Thunkar/ArmDuinoV2/README.md

# ArmDuinoV2
Second version of the robotic arm. Now including hardware, software and (some) documentation.
