Thunkar/ArmDuinoV2/Piezas STL/README.txt

1 Base ventosa
1 BrazoPinza
1 BrazoPinza2
2 Enlace1
2 Enlace2Base
1 Enlace2
1 Pinza
3 SoporteVentosa

5 Servos pequeños http://www.hobbyking.com/hobbyking/store/__32095__Turnigy_TG9_9g_1_7kg_0_12sec_Eco_Micro_Servo.html
2 Servos grandes http://www.hobbyking.com/hobbyking/store/__39340__HXT_6_9kg_39_2g_16sec_Twin_bearing_servo_EU_warehouse_.html
1 Fuente de alimentación 5V 4A (el cacharro consume hasta 2.5-2.7A)
1 Placa Arduino
