Thunkar/ArmDuinoV2/Documentación/KinectMappingVertical.jpg

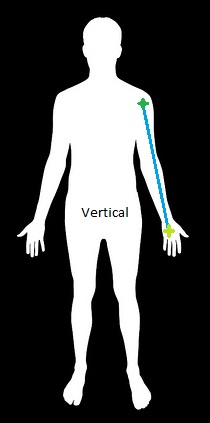
Documentación/KinectMappingVertical.jpg
