Thunkar/ArmDuinoV2/Piezas STL/BrazoCompleto.stl

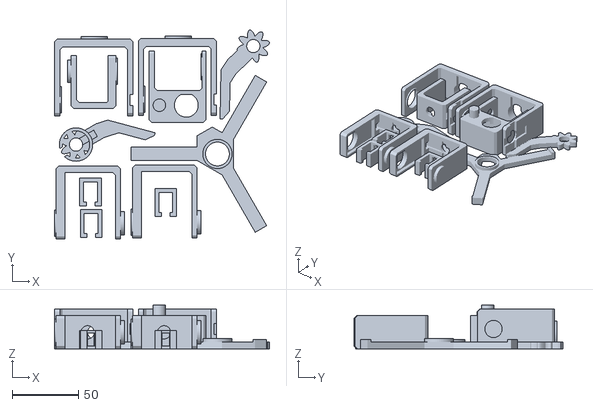
[picture p11: CAD file, 2015-02-28]
Piezas STL/BrazoCompleto.stl
162.3 x 157.9 x 33.0
