Thunkar/ArmDuinoV2/Piezas STL/BrazoPinza2.stl

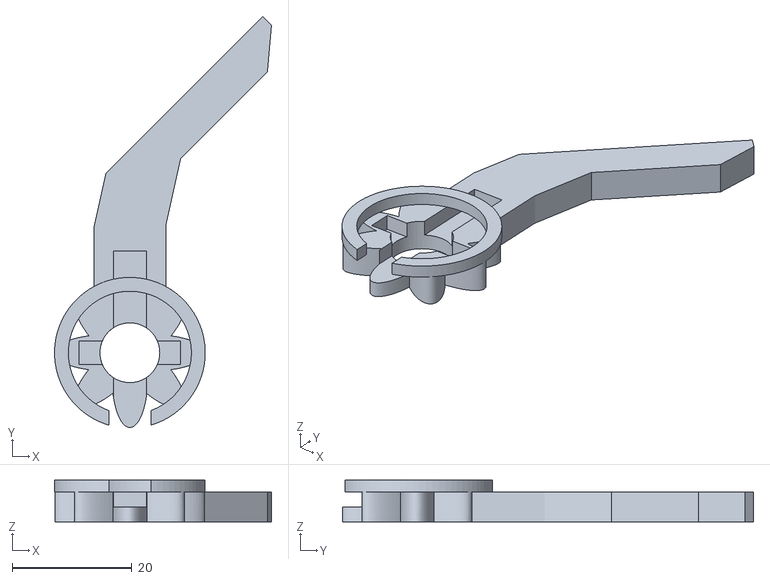
[picture p12: CAD file, 2015-02-28]
Piezas STL/BrazoPinza2.stl
36.3 x 68.7 x 7.00
