Thunkar/ArmDuinoV2/Piezas STL/Enlace1.stl

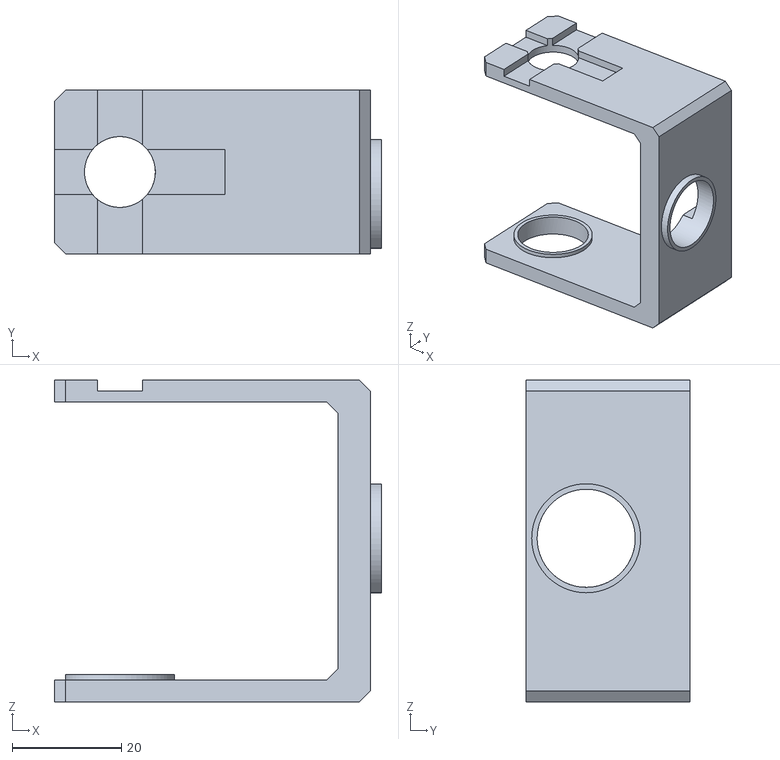
[picture p13: CAD file, 2015-02-28]
Piezas STL/Enlace1.stl
60.0 x 30.0 x 59.0
