Thunkar/ArmDuinoV2/Piezas STL/Pinza.stl

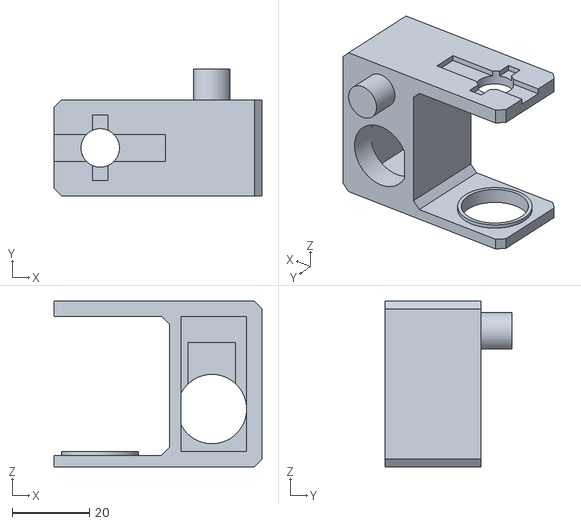
[picture p14: CAD file, 2015-02-28]
Piezas STL/Pinza.stl
54.0 x 33.0 x 43.0
