Thunkar/ArmDuinoV2/Piezas STL/BaseVentosa.stl

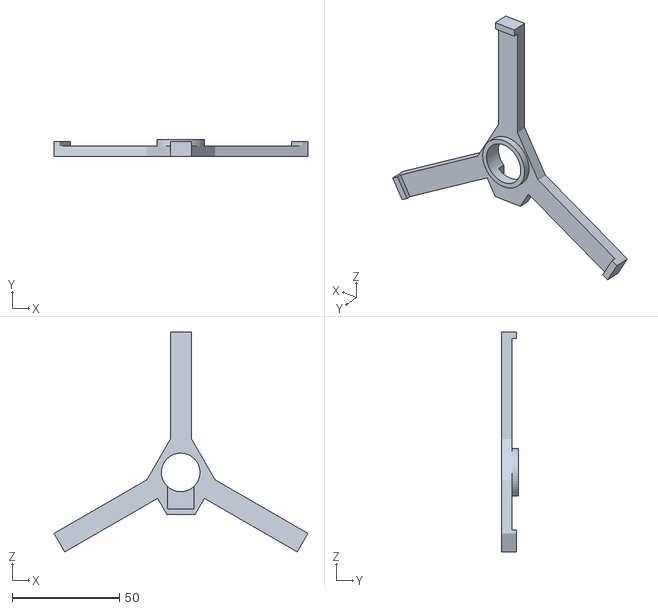
[picture p15: CAD file, 2015-02-28]
Piezas STL/BaseVentosa.stl
118.4 x 8.00 x 102.6
