Thunkar/ArmDuinoV2/Piezas STL/BrazoPinza.stl

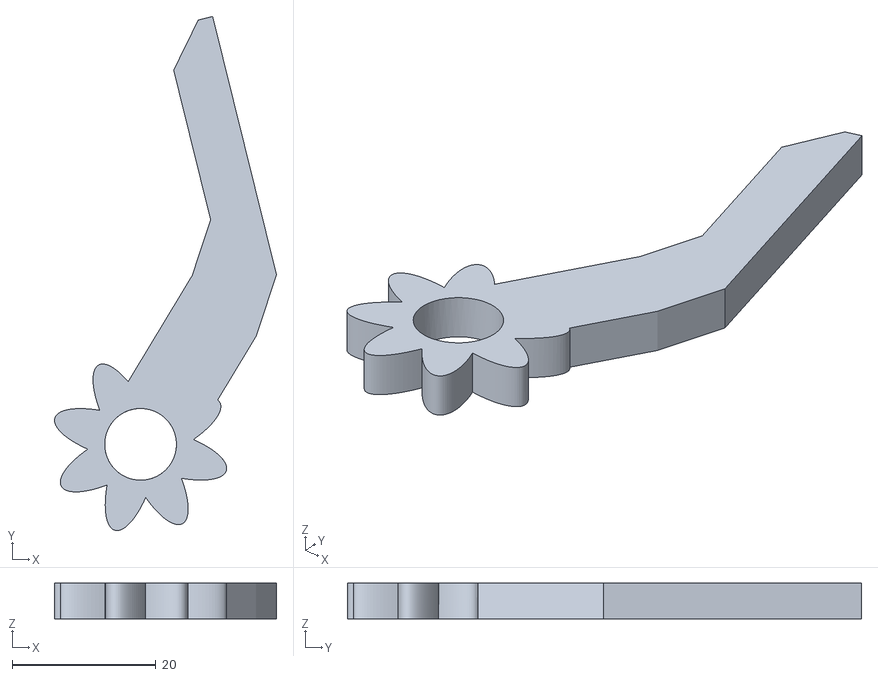
[picture p16: CAD file, 2015-02-28]
Piezas STL/BrazoPinza.stl
30.9 x 71.6 x 5.00
