Thunkar/ArmDuinoV2/Piezas STL/Enlace2Base.stl

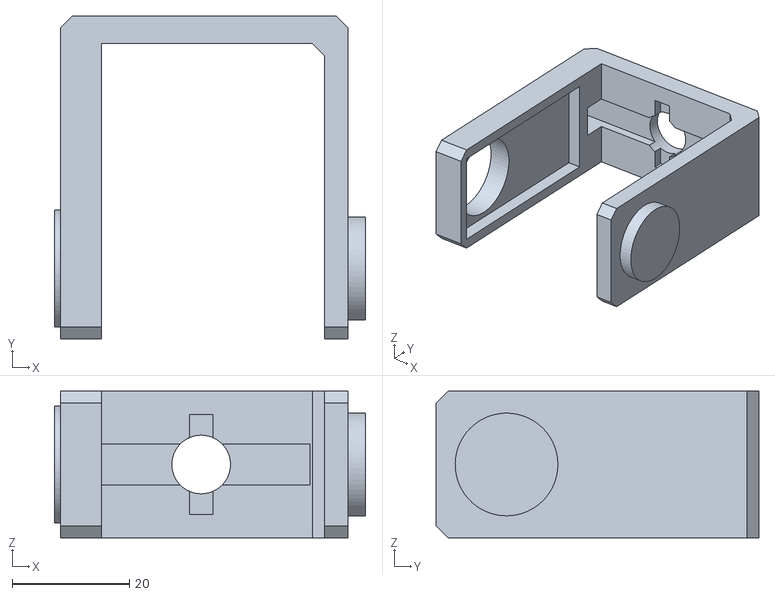
[picture p17: CAD file, 2015-02-28]
Piezas STL/Enlace2Base.stl
53.0 x 55.0 x 25.0
