Thunkar/ArmDuinoV2/Piezas STL/SoporteVentosa.stl

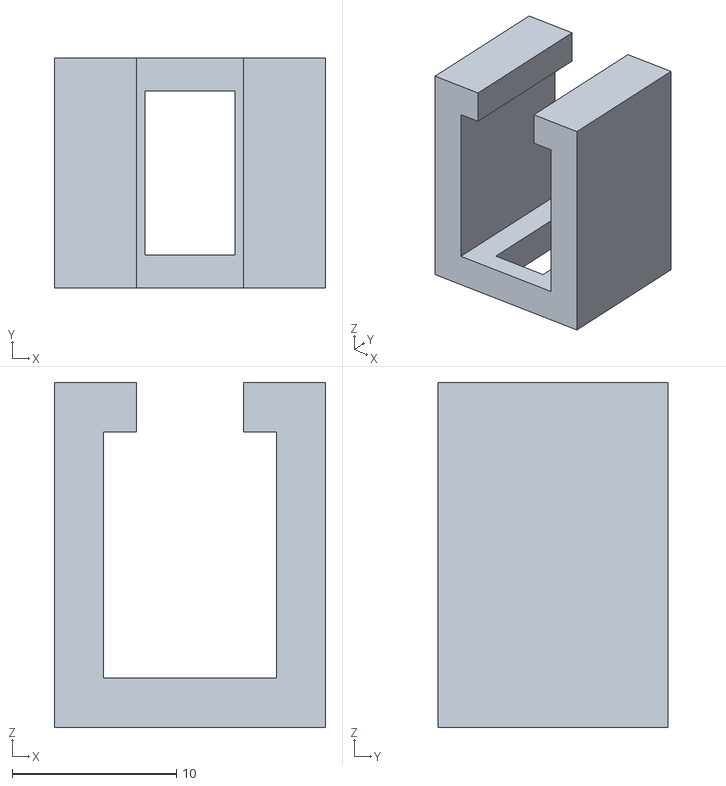
[picture p18: CAD file, 2015-02-28]
Piezas STL/SoporteVentosa.stl
16.5 x 14.0 x 21.0
