Thunkar/ArmDuinoV2/Piezas STL/Enlace2.stl

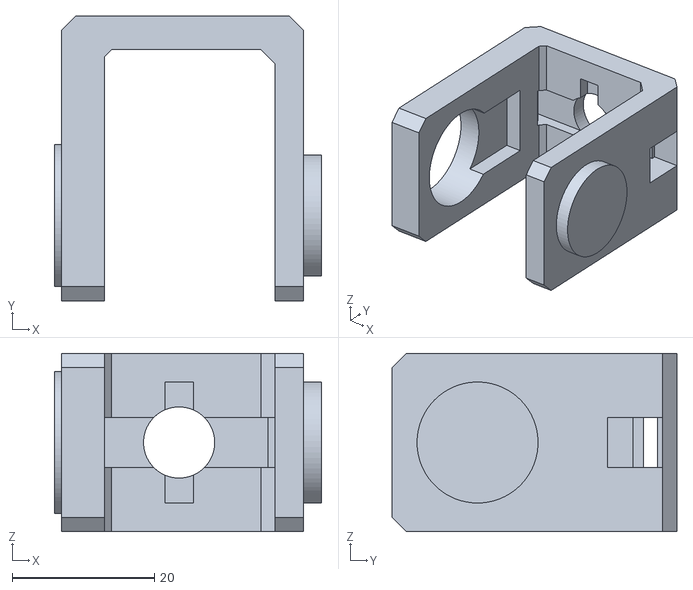
[picture p19: CAD file, 2015-02-28]
Piezas STL/Enlace2.stl
37.5 x 40.0 x 25.0
