Thunkar/ArmDuinoV2/(list of files, cad)

Other CAD files:
Piezas Inventor/Base.ipt
Piezas Inventor/BaseVentosa.ipt
Piezas Inventor/Brazo.iam
Piezas Inventor/BrazoPinza.ipt
Piezas Inventor/BrazoPinza2.ipt
Piezas Inventor/Enlace1.ipt
Piezas Inventor/Enlace2.ipt
Piezas Inventor/Enlace2Base.ipt
Piezas Inventor/OldVersions/BaseVentosa.0004.ipt
Piezas Inventor/OldVersions/Brazo.0084.iam
Piezas Inventor/OldVersions/BrazoPinza.0018.ipt
Piezas Inventor/OldVersions/BrazoPinza2.0017.ipt
Piezas Inventor/OldVersions/Enlace1.0044.ipt
Piezas Inventor/OldVersions/Enlace2.0041.ipt
Piezas Inventor/OldVersions/Enlace2Base.0014.ipt
Piezas Inventor/OldVersions/Servo.0003.ipt
Piezas Inventor/OldVersions/Servo2.0001.ipt
Piezas Inventor/OldVersions/SoporteVentosa.0003.ipt
Piezas Inventor/Pata.ipt
Piezas Inventor/Pinza.ipt
Piezas Inventor/Plano.ipt
Piezas Inventor/Servo.ipt
Piezas Inventor/Servo2.ipt
Piezas Inventor/SoporteVentosa.ipt
