Thunkar/ArmDuinoV2/Electrónica/Motores+Bluetooth/Motores+Bluetoothv4.brd

## EAGLE design Electrónica/Motores+Bluetooth/Motores+Bluetoothv4.brd (2015-02-28)

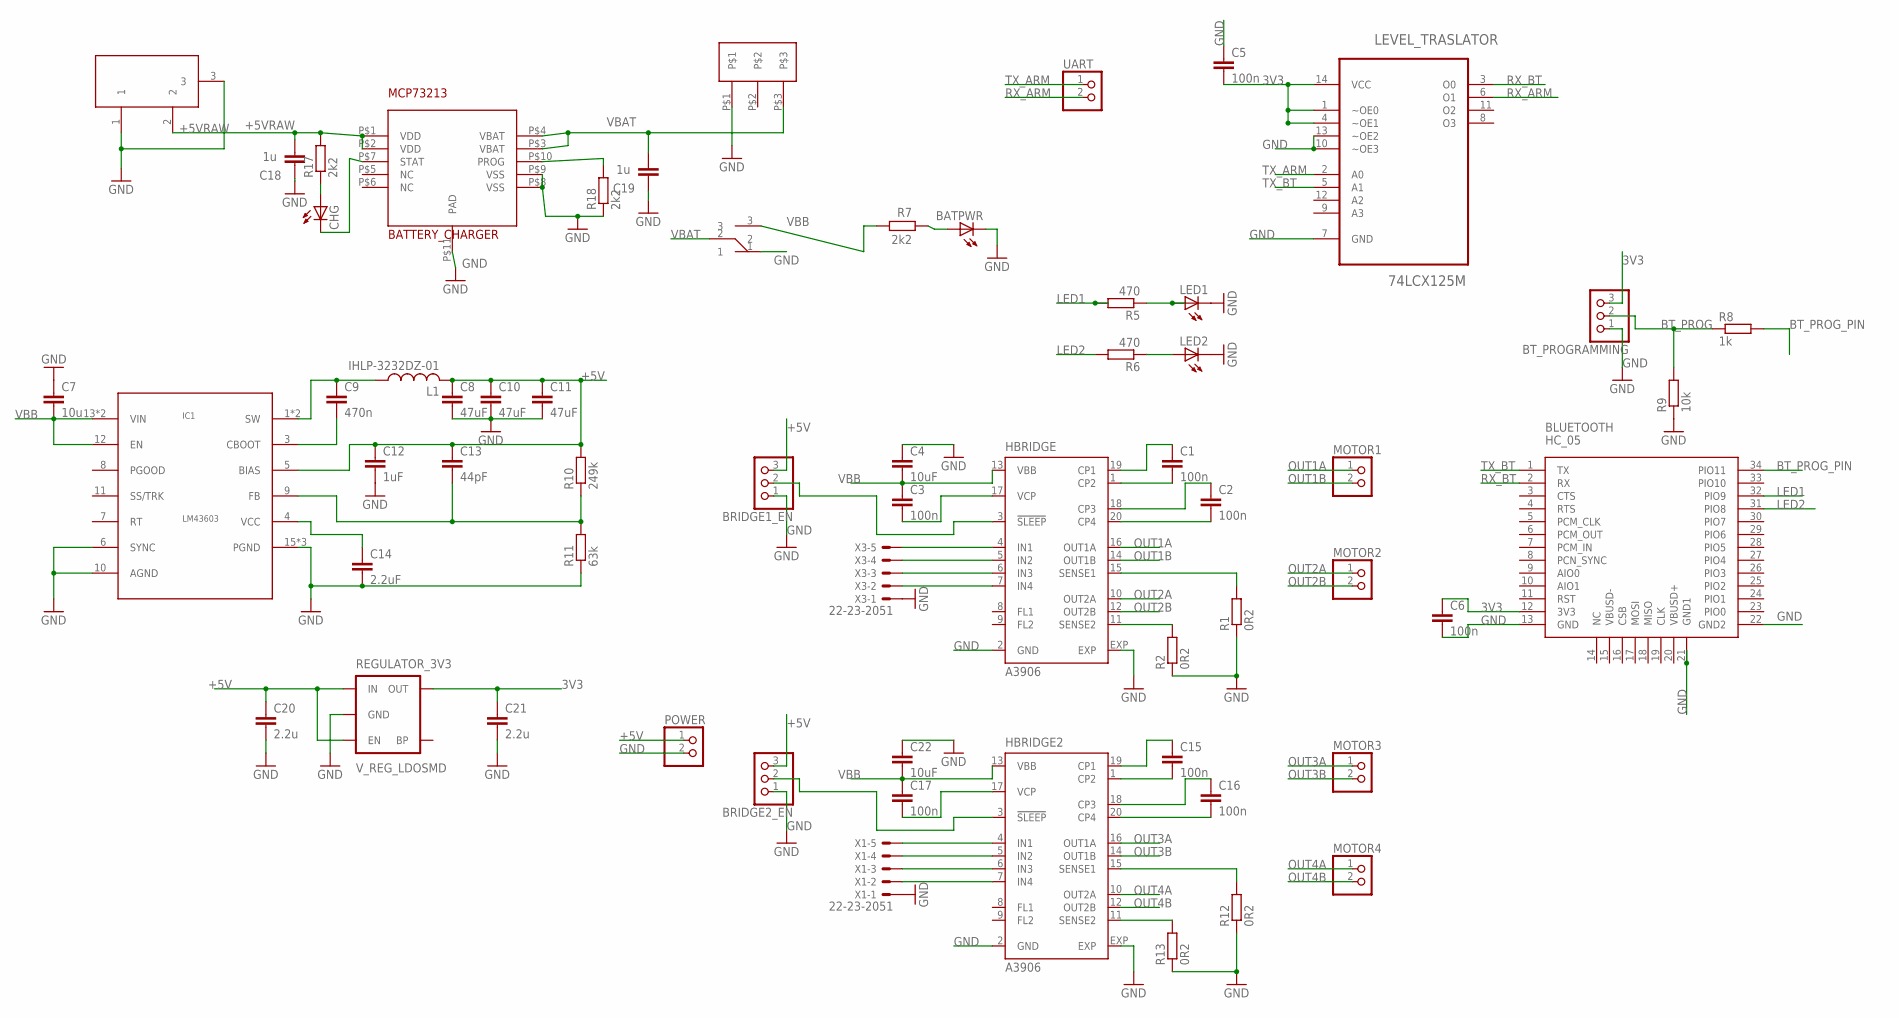
[picture p20: schematic Motores+Bluetoothv4.sch]

Parts:
BATPWR: LEDCHIPLED_0603; CHIPLED_0603
BATTERY_CHARGER: MCP73213; DFN103X3
BLUETOOTH: HC_05; BLUETOOTH_SMD
BRIDGE1_EN, BRIDGE2_EN: PINHD-1X3ROUND; 1X03ROUND
BT_PROGRAMMING: PINHD-1X3ROUND; 1X03ROUND
C1, C2, C3, C5, C6, C15, C16, C17: 100n; C0603
C4, C22: 10uF; C0805
C7: 10u; C1206
C8, C10, C11: 47uF; C1210
C9: 470n; C0603
C12: 1uF; C0805
C13: 44pF; C0603
C14: 2.2uF; C0805
C18, C19: 1u; C0603
C20, C21: 2.2u; C0603K
CHG: LEDCHIPLED_0603; CHIPLED_0603
HBRIDGE, HBRIDGE2: A3906; QFN20
IC1: LM43603; PW_R-PDSO-G16
L1: IHLP-3232DZ-01
LED1, LED2: LEDCHIP-LED0603; CHIP-LED0603
LEVEL_TRASLATOR: 74LCX125M; SOIC127P600X175-14N
MOTOR1, MOTOR2, MOTOR3, MOTOR4: PINHD-1X2ROUND; 1X02ROUND
POWER: PINHD-1X2ROUND; 1X02ROUND
R1, R2, R12, R13: 0R2; R0805
R5, R6: 470; R0603
R7, R17, R18: 2k2; R0603
R8: 1k; R0603
R9: 10k; R0603
R10: 249k; R0603
R11: 63k; R0603
REGULATOR_3V3: V_REG_LDOSMD; SOT23-5
U$1: 100SP1T1B4M2QE
U$3: JST-XHA-3
UART: PINHD-1X2ROUND; 1X02ROUND
X1, X3: 22-23-2051
X2: DC21MMX; DC-21MM

Connections:
3V3: BLUETOOTH.12 (3V3), BT_PROGRAMMING.3, C5.2, C6.1, C21.1, LEVEL_TRASLATOR.1 (~OE0), LEVEL_TRASLATOR.4 (~OE1), LEVEL_TRASLATOR.14 (VCC), REGULATOR_3V3.5 (OUT)
+5V: BRIDGE1_EN.3, BRIDGE2_EN.3, C8.1, C10.1, C11.1, C12.1, C13.1, C20.1, IC1.5 (BIAS), L1.P$2 (2), POWER.1, R10.2, REGULATOR_3V3.1 (IN), REGULATOR_3V3.3 (EN)
+5VRAW: BATTERY_CHARGER.P$1 (VDD), BATTERY_CHARGER.P$2 (VDD), C18.1, R17.2, X2.2
BT_PROG: BT_PROGRAMMING.2, R8.1, R9.2
BT_PROG_PIN: BLUETOOTH.34 (PIO11), R8.2
GND: BATPWR.C, BATTERY_CHARGER.P$8 (VSS), BATTERY_CHARGER.P$9 (VSS), BATTERY_CHARGER.P$11 (PAD), BLUETOOTH.13 (GND), BLUETOOTH.21 (GND1), BLUETOOTH.22 (GND2), BRIDGE1_EN.1, BRIDGE2_EN.1, BT_PROGRAMMING.1, C4.1, C5.1, C6.2, C7.1, C8.2, C10.2, C11.2, C12.2, C14.2, C18.2, C19.2, C20.2, C21.2, C22.1, HBRIDGE.2 (GND), HBRIDGE.EXP, HBRIDGE2.2 (GND), HBRIDGE2.EXP, IC1.6 (SYNC), IC1.10 (AGND), IC1.15 (PGND), IC1.16 (PGND), IC1.TP (PGND), LED1.C, LED2.C, LEVEL_TRASLATOR.7 (GND), LEVEL_TRASLATOR.10 (~OE3), LEVEL_TRASLATOR.13 (~OE2), POWER.2, R1.1, R2.1, R9.1, R11.1, R12.1, R13.1, R18.1, REGULATOR_3V3.2 (GND), U$1.1, U$3.P$1, X1.1, X2.1, X2.3, X3.1
LED1: BLUETOOTH.32 (PIO9), R5.2
LED2: BLUETOOTH.31 (PIO8), R6.2
unnamed: C1.1, HBRIDGE.19 (CP1)
unnamed: C1.2, HBRIDGE.1 (CP2)
unnamed: C2.1, HBRIDGE.18 (CP3)
unnamed: C2.2, HBRIDGE.20 (CP4)
unnamed: C3.2, HBRIDGE.17 (VCP)
unnamed: LED2.A, R6.1
unnamed: HBRIDGE.15 (SENSE1), R1.2
unnamed: HBRIDGE.11 (SENSE2), R2.2
unnamed: HBRIDGE.4 (IN1), X3.5
unnamed: HBRIDGE.5 (IN2), X3.4
unnamed: HBRIDGE.6 (IN3), X3.3
unnamed: HBRIDGE.7 (IN4), X3.2
unnamed: BRIDGE1_EN.2, HBRIDGE.3 (!SLEEP)
unnamed: LED1.A, R5.1
unnamed: BATPWR.A, R7.2
unnamed: C9.2, IC1.3 (CBOOT)
unnamed: C9.1, IC1.1 (SW), IC1.2 (SW), L1.P$1 (1)
unnamed: C14.1, IC1.4 (VCC)
unnamed: C13.2, IC1.9 (FB), R10.1, R11.2
unnamed: C15.1, HBRIDGE2.19 (CP1)
unnamed: C15.2, HBRIDGE2.1 (CP2)
unnamed: C16.1, HBRIDGE2.18 (CP3)
unnamed: C16.2, HBRIDGE2.20 (CP4)
unnamed: C17.2, HBRIDGE2.17 (VCP)
unnamed: HBRIDGE2.15 (SENSE1), R12.2
unnamed: HBRIDGE2.11 (SENSE2), R13.2
unnamed: HBRIDGE2.4 (IN1), X1.5
unnamed: HBRIDGE2.5 (IN2), X1.4
unnamed: HBRIDGE2.6 (IN3), X1.3
unnamed: HBRIDGE2.7 (IN4), X1.2
unnamed: BRIDGE2_EN.2, HBRIDGE2.3 (!SLEEP)
unnamed: CHG.A, R17.1
unnamed: BATTERY_CHARGER.P$7 (STAT), CHG.C
unnamed: BATTERY_CHARGER.P$10 (PROG), R18.2
OUT1A: HBRIDGE.16 (OUT1A), MOTOR1.1
OUT1B: HBRIDGE.14 (OUT1B), MOTOR1.2
OUT2A: HBRIDGE.10 (OUT2A), MOTOR2.1
OUT2B: HBRIDGE.12 (OUT2B), MOTOR2.2
OUT3A: HBRIDGE2.16 (OUT1A), MOTOR3.1
OUT3B: HBRIDGE2.14 (OUT1B), MOTOR3.2
OUT4A: HBRIDGE2.10 (OUT2A), MOTOR4.1
OUT4B: HBRIDGE2.12 (OUT2B), MOTOR4.2
RX_ARM: LEVEL_TRASLATOR.6 (O1), UART.2
RX_BT: BLUETOOTH.2 (RX), LEVEL_TRASLATOR.3 (O0)
TX_ARM: LEVEL_TRASLATOR.2 (A0), UART.1
TX_BT: BLUETOOTH.1 (TX), LEVEL_TRASLATOR.5 (A1)
VBAT: BATTERY_CHARGER.P$3 (VBAT), BATTERY_CHARGER.P$4 (VBAT), C19.1, U$1.2, U$3.P$3
VBB: C3.1, C4.2, C7.2, C17.1, C22.2, HBRIDGE.13 (VBB), HBRIDGE2.13 (VBB), IC1.12 (EN), IC1.13 (VIN), IC1.14 (VIN), R7.1, U$1.3

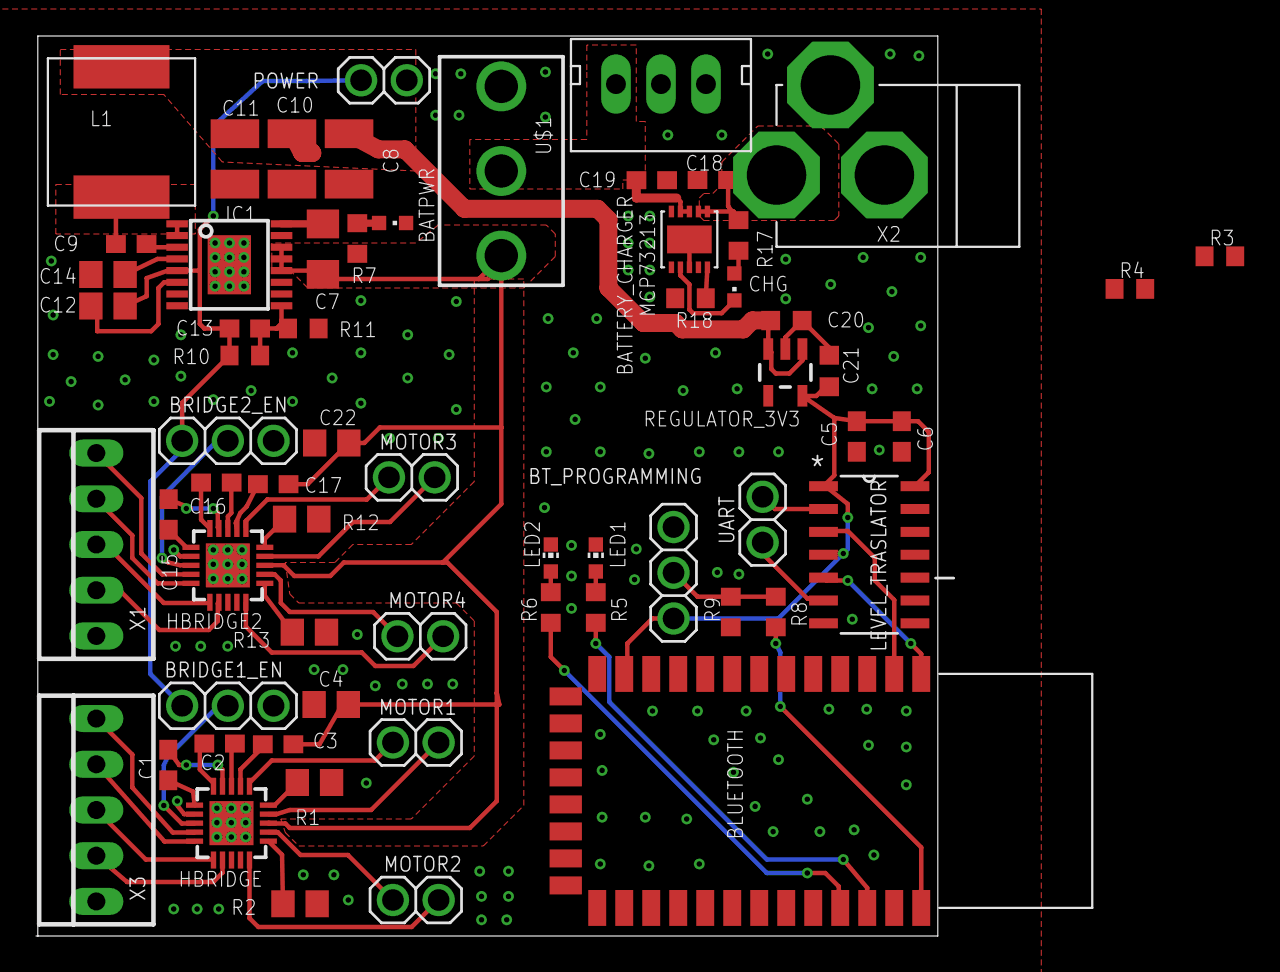
[picture p21: board Motores+Bluetoothv4.brd from above]

Board: 2 copper layers, 50.0 x 50.0 mm, 63 parts (0 on the bottom side), 56 nets.

Other parts of the board:
R3: R0603
R4: NM; R0603
