Thunkar/ArmDuinoV2/Electrónica/ArmDuino v1.4/Armduino v14.brd

## EAGLE design Electrónica/ArmDuino v1.4/Armduino v14.brd (2015-02-28)

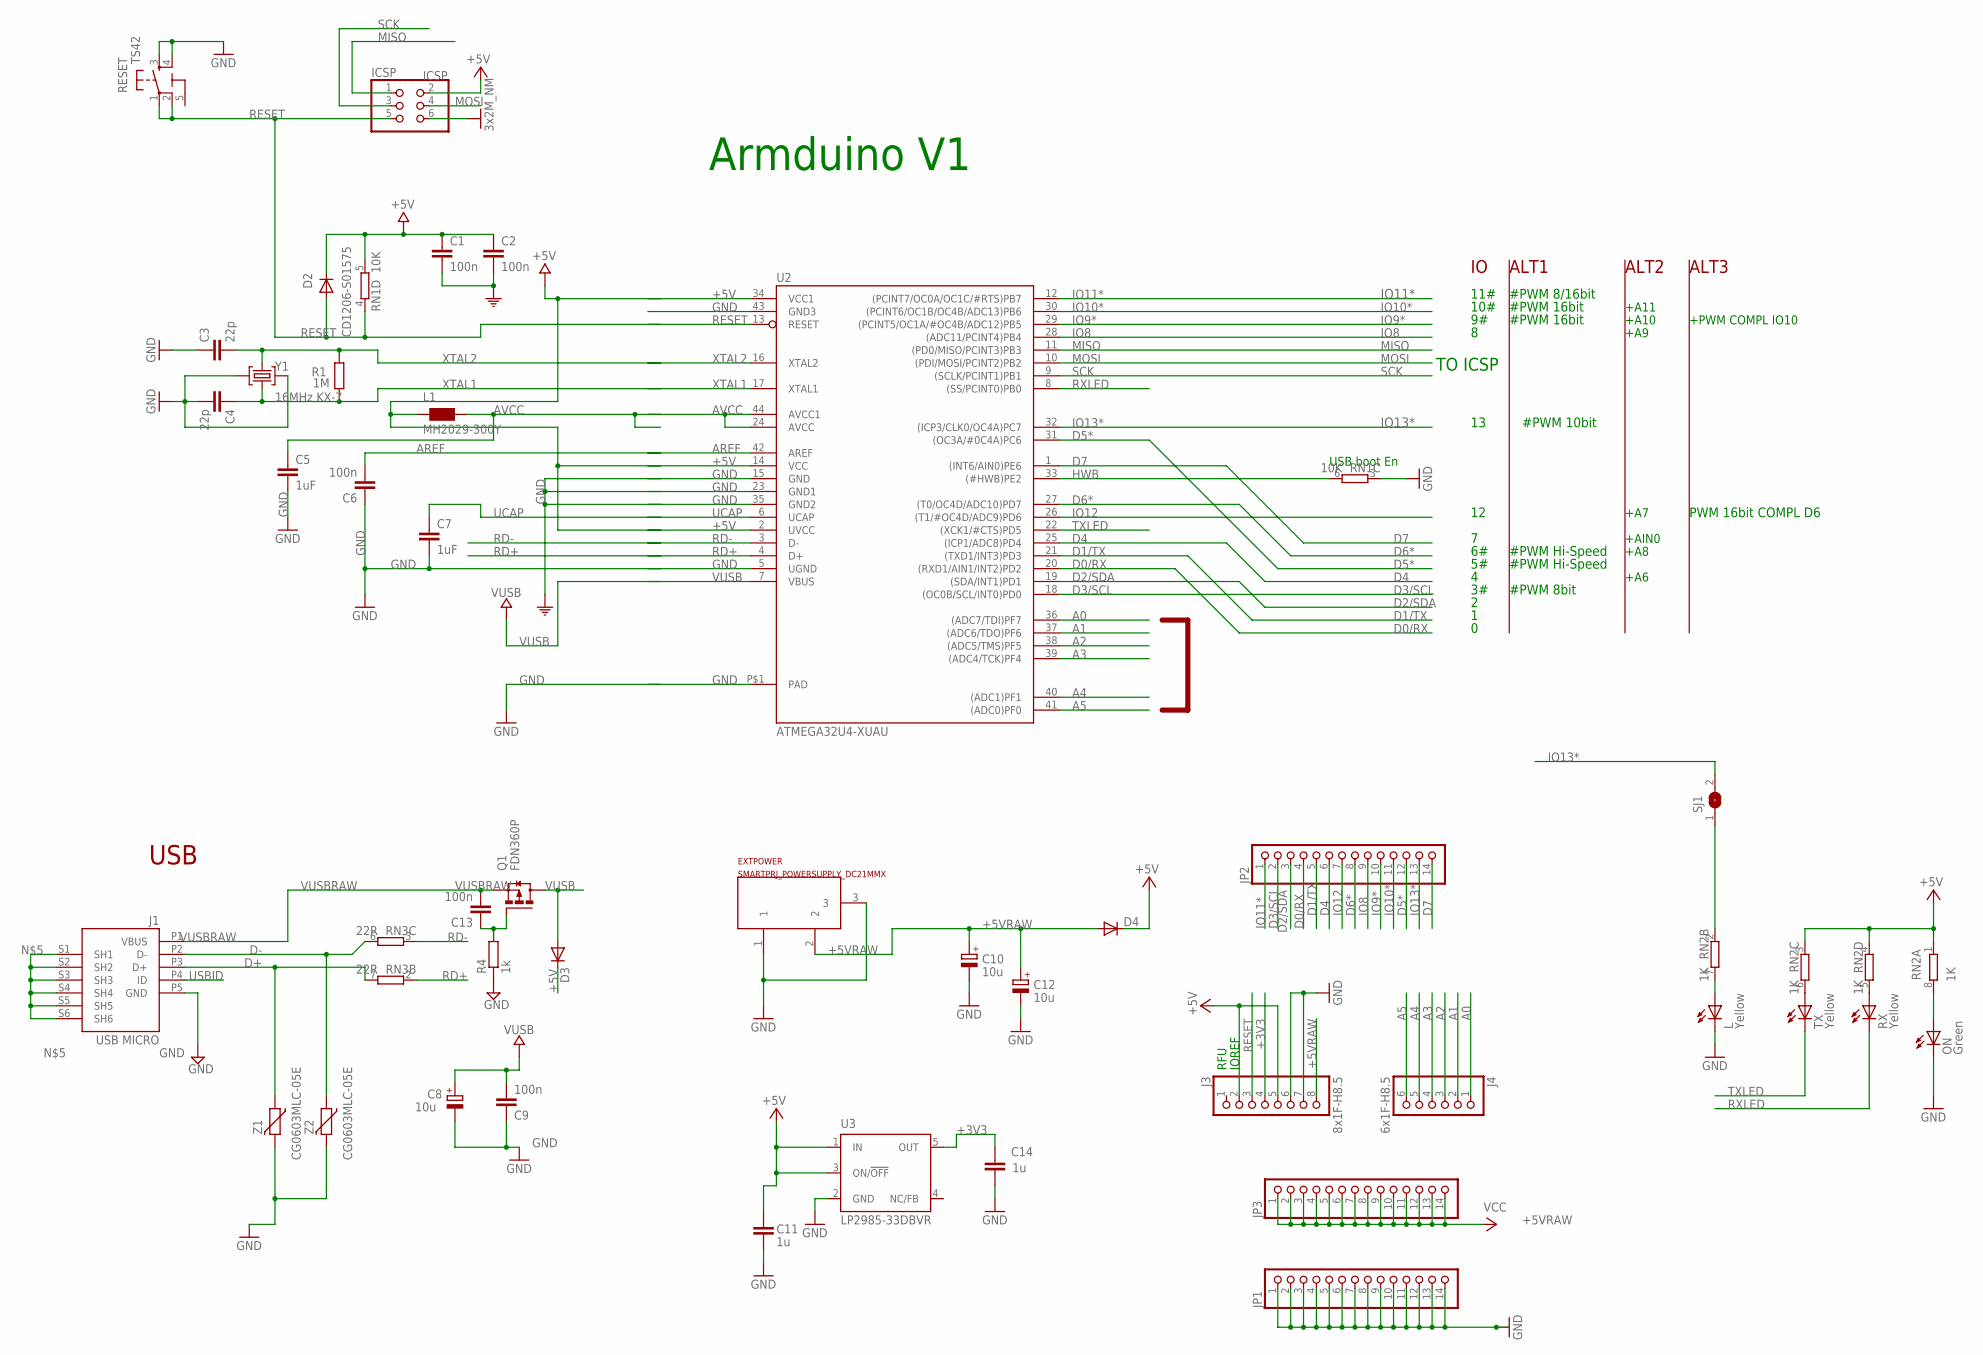
[picture p22: schematic Armduino v14.sch]

Parts:
C1, C2, C6, C9: 100n; C0603-ROUND
C3, C4: 22p; C0603-ROUND
C5, C7: 1uF; C0603-ROUND
C8, C10, C12: 10u; SMC_B
C11, C14: 1u; C0603-ROUND
C13: 100n; C0603
D2: CD1206-S01575; MINIMELF
D3, D4: DIODE-SOD123; SOD123
EXTPOWER: SMARTPRJ_POWERSUPPLY_DC21MMX; SMARTPRJ_POWERSUPPLY_DC-21MM
ICSP: ICSP; 2X03
J1: USB MICRO; SMARTPRJ_CON2_USB_MICRO_B_AT
J3: 8x1F-H8.5; 1X08
J4: 6x1F-H8.5; 1X06
JP1, JP2, JP3: PINHD-1X14; 1X14ROUND
L: Yellow; CHIPLED_0805
L1: MH2029-300Y; 0805
ON: Green; CHIPLED_0805
Q1: FDN360P; SUPER-SOT3
R1: 1M; R0603-ROUND
R4: 1k; R0603
RESET: TS42
RN1: 10K; CAY16
RN2: 1K; CAY16
RN3: 22R; CAY16
RX: Yellow; CHIPLED_0805
SJ1: SJ
TX: Yellow; CHIPLED_0805
U2: ATMEGA32U4-XUAU; TQFP44-PAD
U3: LP2985-33DBVR; SOT23-DBV
Y1: 16MHz KX-7; CRYSTAL-3.2-2.5
Z1, Z2: CG0603MLC-05E; CT/CN0603

Connections:
5-GND: RESET.5 (5-GND)
+3V3: C14.2, J3.4, U3.5 (OUT)
+5V: C1.1, C2.1, C11.2, D2.C, D3.C, D4.C, ICSP.2, J3.2, J3.5, L1.1, RN1.5 (2), RN2.1, RN2.3 (1), RN2.4 (1), U2.2 (UVCC), U2.14 (VCC), U2.34 (VCC1), U3.1 (IN), U3.3 (ON/!OFF)
+5VRAW: C10.+, C12.+, D4.A, EXTPOWER.2, J3.8, JP3.1, JP3.2, JP3.3, JP3.4, JP3.5, JP3.6, JP3.7, JP3.8, JP3.9, JP3.10, JP3.11, JP3.12, JP3.13, JP3.14
A0: J4.1, U2.36 ((ADC7/TDI)PF7)
A1: J4.2, U2.37 ((ADC6/TDO)PF6)
A2: J4.3, U2.38 ((ADC5/TMS)PF5)
A3: J4.4, U2.39 ((ADC4/TCK)PF4)
A4: J4.5, U2.40 ((ADC1)PF1)
A5: J4.6, U2.41 ((ADC0)PF0)
AREF: C6.2, U2.42 (AREF)
AVCC: C5.1, L1.2, U2.24 (AVCC), U2.44 (AVCC1)
D0/RX: JP2.4, U2.20 ((RXD1/AIN1/INT2)PD2)
D1/TX: JP2.5, U2.21 ((TXD1/INT3)PD3)
D2/SDA: JP2.3, U2.19 ((SDA/INT1)PD1)
D3/SCL: JP2.2, U2.18 ((OC0B/SCL/INT0)PD0)
D4: JP2.6, U2.25 ((ICP1/ADC8)PD4)
D5*: JP2.12, U2.31 ((OC3A/#0C4A)PC6)
D6*: JP2.8, U2.27 ((T0/OC4D/ADC10)PD7)
D7: JP2.14, U2.1 ((INT6/AIN0)PE6)
D+: J1.P3 (D+), RN3.7 (2), Z1.1
D-: J1.P2 (D-), RN3.6 (2), Z2.1
GND: C1.2, C2.2, C3.1, C4.2, C5.2, C6.1, C7.2, C8.-, C9.1, C10.-, C11.1, C12.-, C14.1, EXTPOWER.1, EXTPOWER.3, ICSP.6, J1.P5 (GND), J3.6, J3.7, JP1.1, JP1.2, JP1.3, JP1.4, JP1.5, JP1.6, JP1.7, JP1.8, JP1.9, JP1.10, JP1.11, JP1.12, JP1.13, JP1.14, L.C, ON.C, R4.1, RESET.3, RESET.4, RN1.3 (1), U2.5 (UGND), U2.15 (GND), U2.23 (GND1), U2.35 (GND2), U2.43 (GND3), U2.P$1 (PAD), U3.2 (GND), Y1.2 (GND), Y1.4 (GND), Z1.2, Z2.2
HWB: RN1.6 (2), U2.33 ((#HWB)PE2)
IO8: JP2.9, U2.28 ((ADC11/PCINT4)PB4)
IO9*: JP2.10, U2.29 ((PCINT5/OC1A/#OC4B/ADC12)PB5)
IO10*: JP2.11, U2.30 ((PCINT6/OC1B/OC4B/ADC13)PB6)
IO11*: JP2.1, U2.12 ((PCINT7/OC0A/OC1C/#RTS)PB7)
IO12: JP2.7, U2.26 ((T1/#OC4D/ADC9)PD6)
IO13*: JP2.13, SJ1.2, U2.32 ((ICP3/CLK0/OC4A)PC7)
LL: RN2.2 (1), SJ1.1
MISO: ICSP.1, U2.11 ((PD0/MISO/PCINT3)PB3)
MOSI: ICSP.4, U2.10 ((PDI/MOSI/PCINT2)PB2)
unnamed: C13.1, Q1.1 (G), R4.2
unnamed: L.A, RN2.7 (2)
unnamed: ON.A, RN2.8 (2)
unnamed: J1.S1 (SH1), J1.S2 (SH2), J1.S3 (SH3), J1.S4 (SH4), J1.S5 (SH5), J1.S6 (SH6)
unnamed: RN2.6 (2), TX.A
unnamed: RN2.5 (2), RX.A
RD+: RN3.2 (1), U2.4 (D+)
RD-: RN3.3 (1), U2.3 (D-)
RESET: D2.A, ICSP.5, J3.3, RESET.1, RESET.2, RN1.4 (1), U2.13 (RESET)
RXLED: RX.C, U2.8 ((SS/PCINT0)PB0)
SCK: ICSP.3, U2.9 ((SCLK/PCINT1)PB1)
TXLED: TX.C, U2.22 ((XCK1/#CTS)PD5)
UCAP: C7.1, U2.6 (UCAP)
USBID: J1.P4 (ID)
VUSB: C8.+, C9.2, D3.A, Q1.3 (D), U2.7 (VBUS)
VUSBRAW: C13.2, J1.P1 (VBUS), Q1.2 (S)
XTAL1: C4.1, R1.1, U2.17 (XTAL1), Y1.1 (C1)
XTAL2: C3.2, R1.2, U2.16 (XTAL2), Y1.3 (C2)

Notes on the sheet:
Armduino V1
USB boot En
USB
TO ICSP
10#
11#
#PWM 8bit
#PWM Hi-Speed
#PWM 8/16bit
#PWM 16bit
PWM 16bit COMPL D6
#PWM 10bit
+A6
+A7
IOREF
RFU
+A11
+A10
+A8
+A9
+PWM COMPL IO10
+AIN0
ALT1
ALT2
ALT3

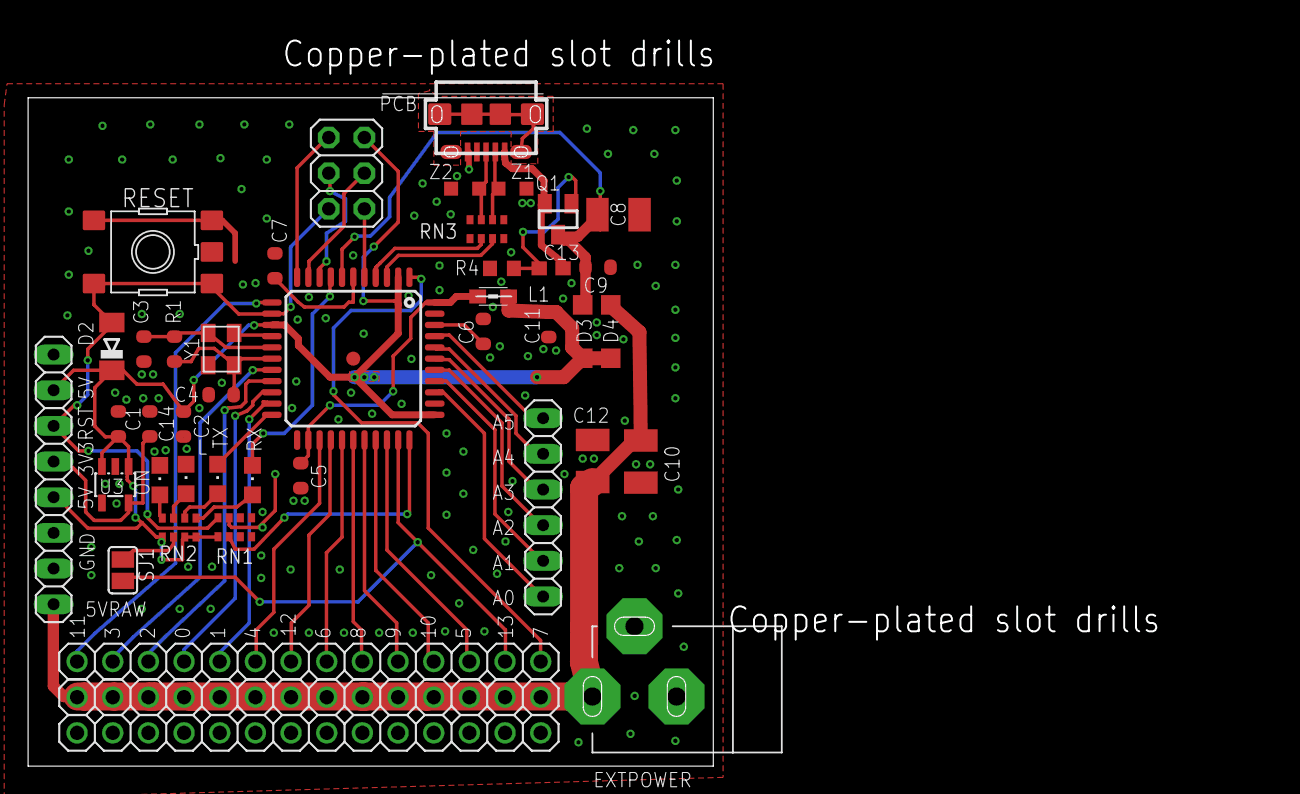
[picture p23: board Armduino v14.brd from above]

Board: 2 copper layers, 48.8 x 47.6 mm, 43 parts (0 on the bottom side), 49 nets.
