Thunkar/ArmDuinoV2/(commit log)

2015-02-23 Added voice control commands and automatic tab switching.
2015-02-28 Fixed project structure and added software and documentation. Thanks, #dotNETconference! ^^
    [Armduino v14.brd, Armduino v14.sch, Base.ipt, BaseVentosa.0004.ipt, BaseVentosa.ipt, BaseVentosa.stl, Brazo.0084.iam, Brazo.iam]
